Bed-Of-Nails-Test-Fixture-Senior-Design/Hardware/README.md

## HARDWARE - BED OF NAILS TEST FIXTURE
In order to have all the library dependencies resolved, you may have to clone the following library: https://github.com/waltoncade/ComLib

BOM: https://docs.google.com/spreadsheets/d/1WrwzJUxgYZxQ-m_5U3LW8MFK-BtWamYw5t6W2Ptqv70/edit?usp=sharing
