Bed-Of-Nails-Test-Fixture-Senior-Design/Hardware/LTSpice/CutoffvsStopband.png

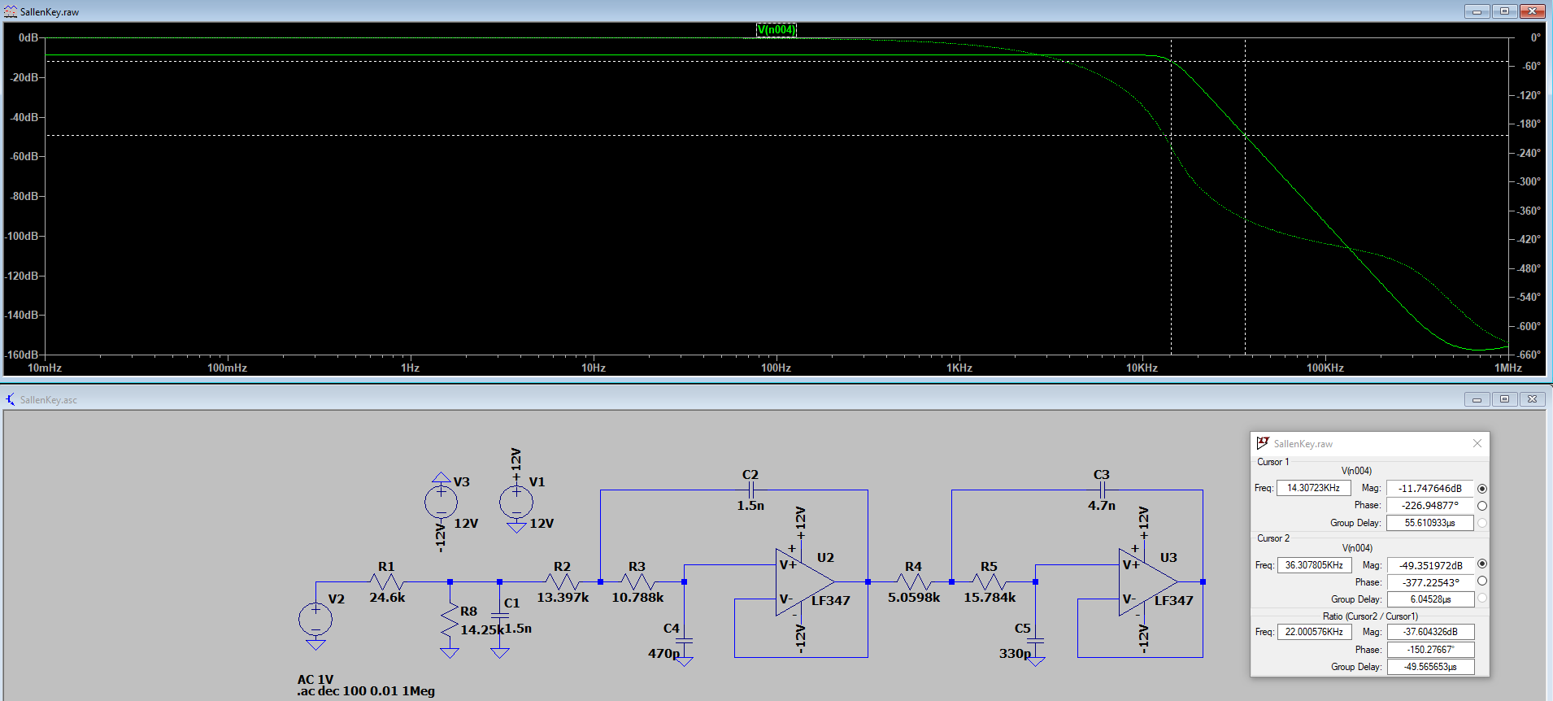
LTSpice/CutoffvsStopband.png
