Bed-Of-Nails-Test-Fixture-Senior-Design/Hardware/LTSpice/Input_Impedance.png

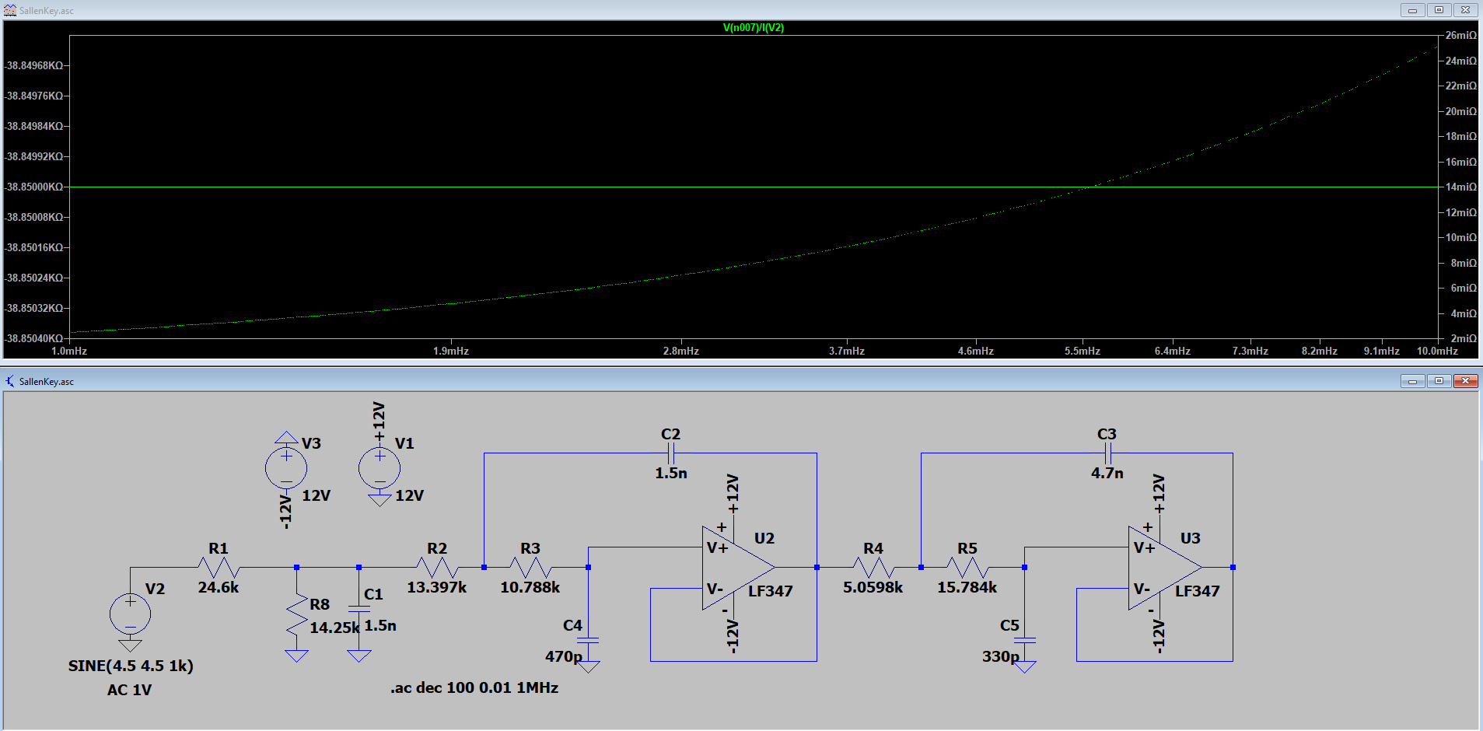
LTSpice/Input_Impedance.png
