Bed-Of-Nails-Test-Fixture-Senior-Design/Hardware/LTSpice/PassbandvsCutoff.png

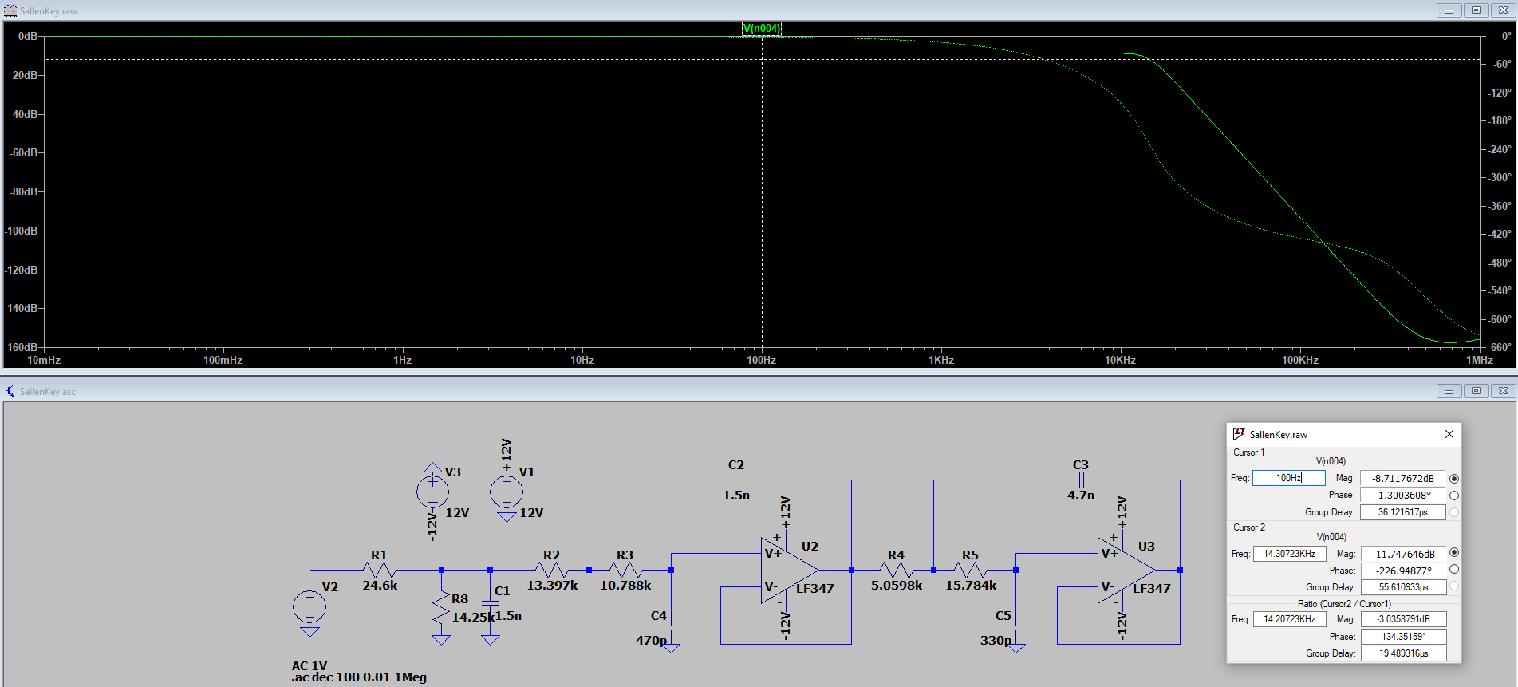
LTSpice/PassbandvsCutoff.png
