Bed-Of-Nails-Test-Fixture-Senior-Design/Hardware/LTSpice/Filters/Real_Test/Expected_Test.png

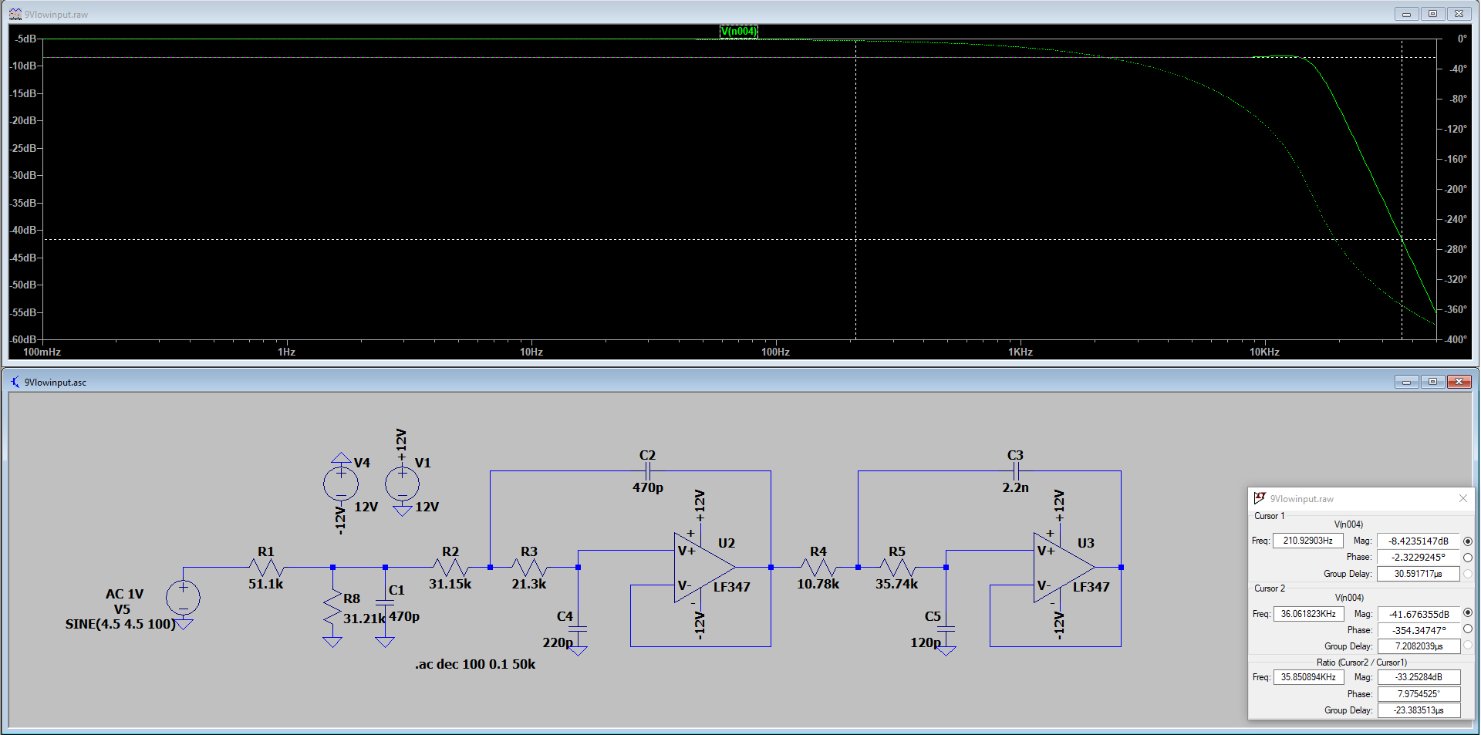
LTSpice/Filters/Real_Test/Expected_Test.png
