Bed-Of-Nails-Test-Fixture-Senior-Design/Hardware/KiCAD/Outputs/Pancake.pdf

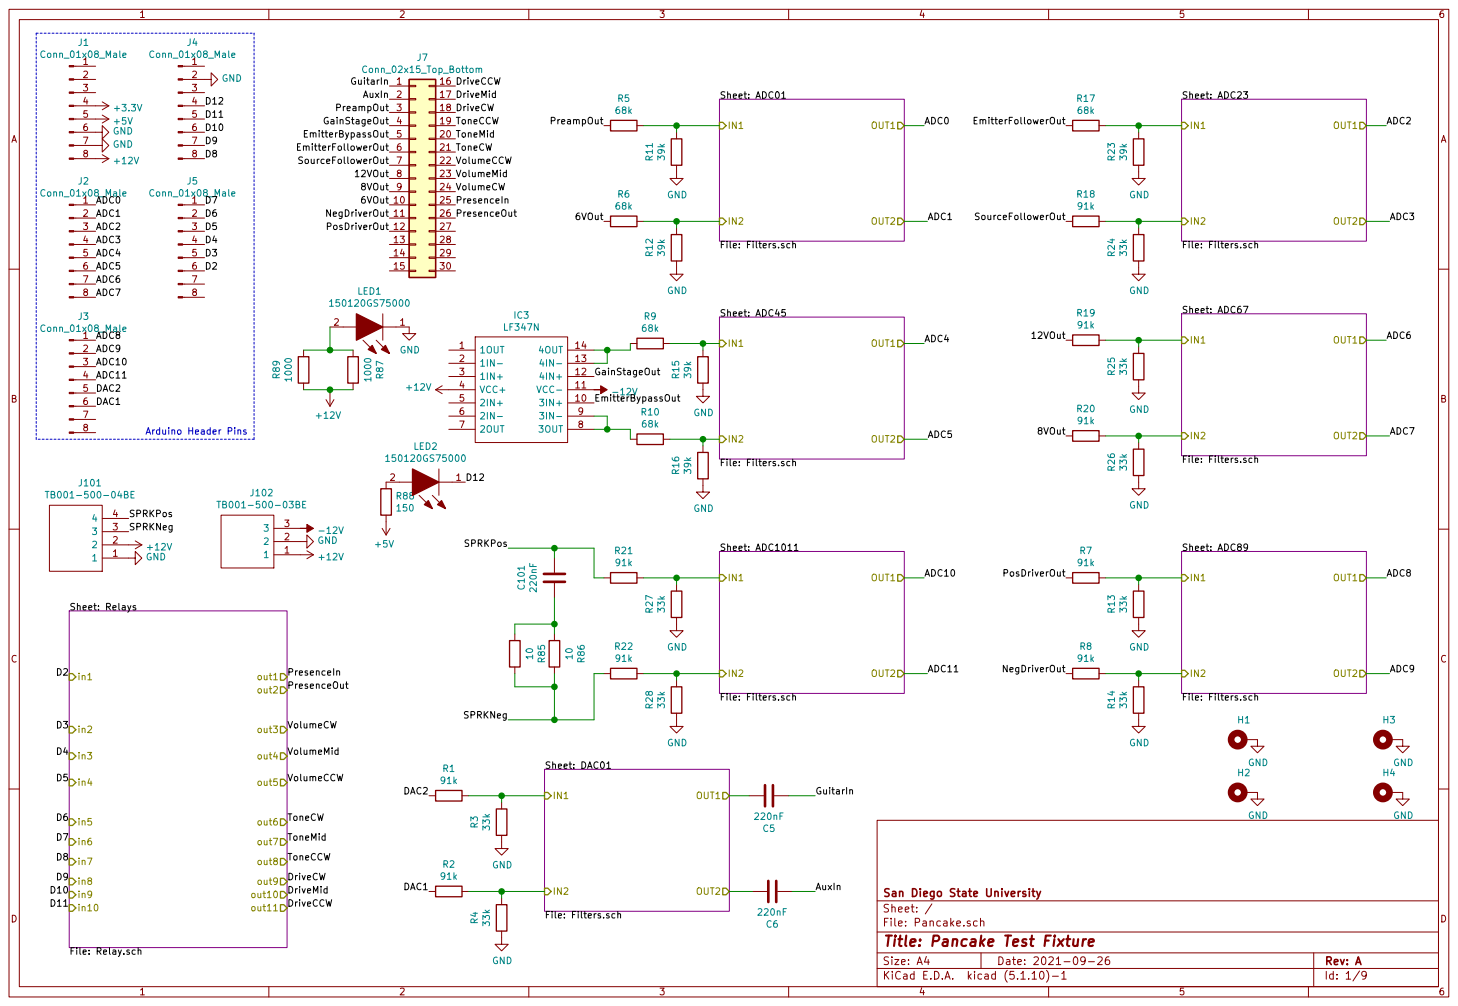
[picture p8: page 1]

PreampOut GuitarIn D9 Arduino Header Pins

Sheet: ADC01 File: Filters.sch

Sheet: ADC23 File: Filters.sch

Sheet: ADC45 File: Filters.sch

File: Pancake.sch Sheet: / San Diego State University

Id: 1/9 Title: Pancake Test Fixture

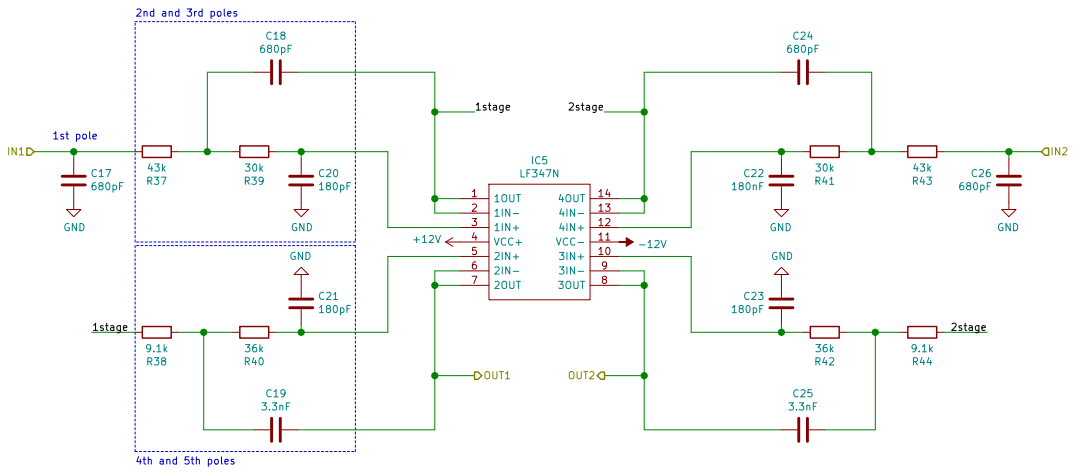
[picture p9: page 2]

File: Filters.sch Sheet: /ADC1011/ San Diego State University

Id: 2/9 Title: Pancake Test Fixture

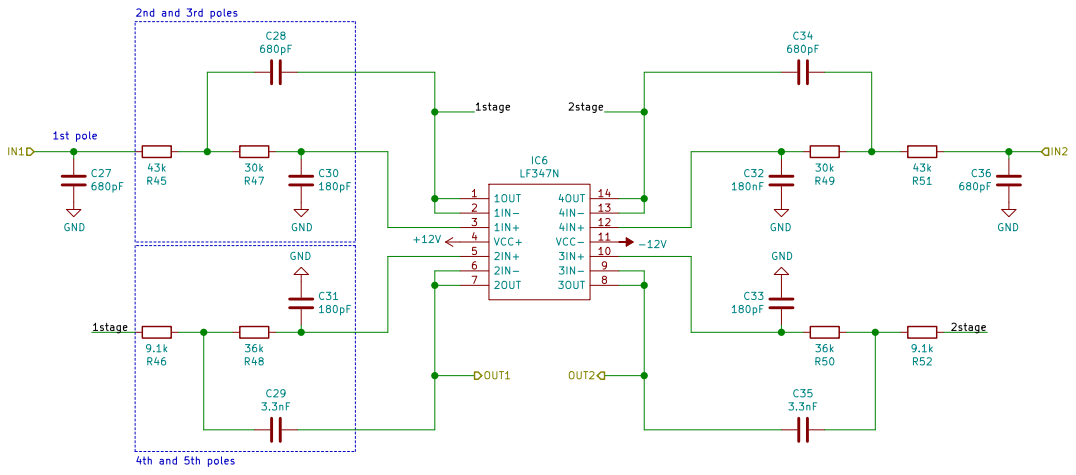
[picture p10: page 3]

File: Filters.sch Sheet: /ADC67/ San Diego State University

Id: 3/9 Title: Pancake Test Fixture

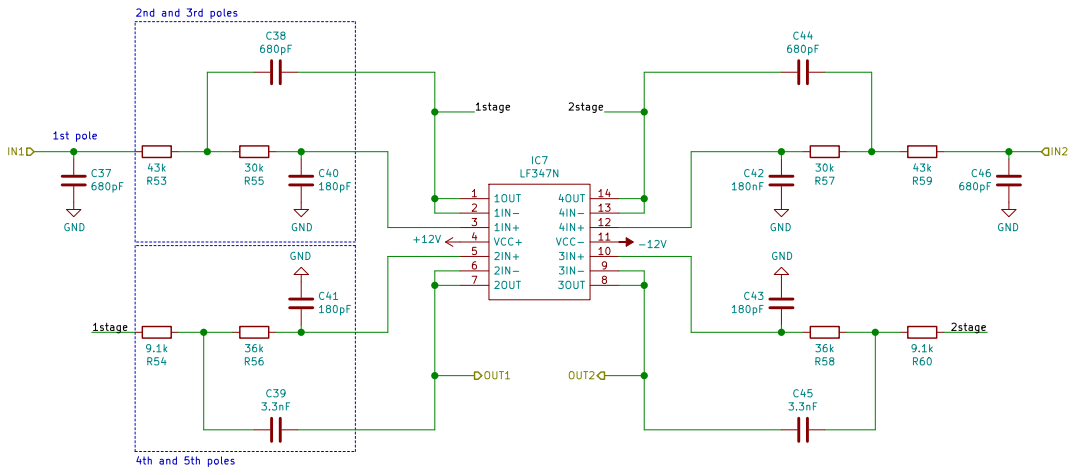
[picture p11: page 4]

File: Filters.sch Sheet: /ADC23/ San Diego State University

Id: 4/9 Title: Pancake Test Fixture

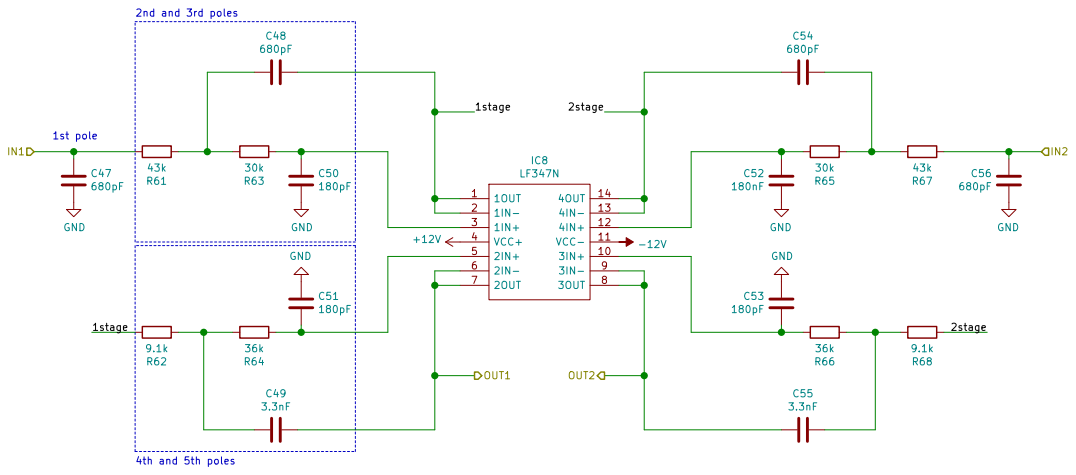
[picture p12: page 5]

File: Filters.sch Sheet: /ADC45/ San Diego State University

Id: 5/9 Title: Pancake Test Fixture

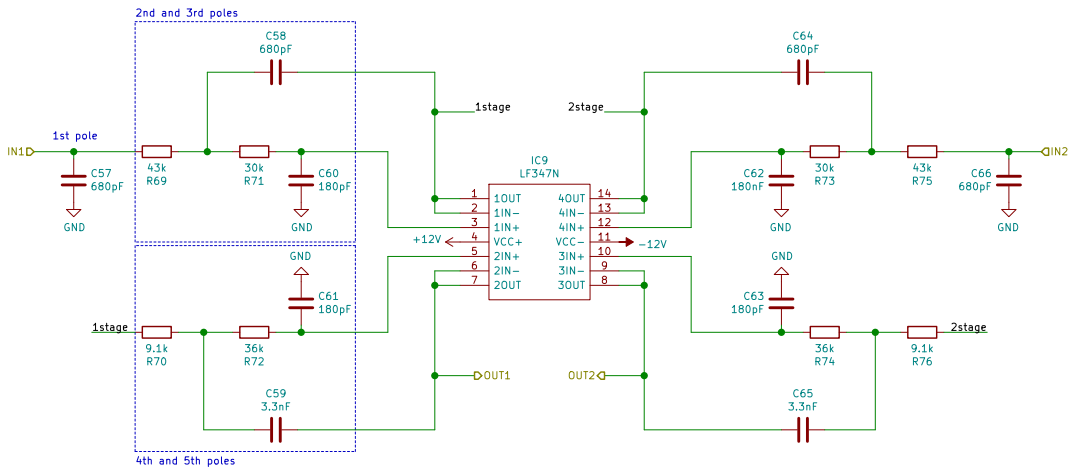
[picture p13: page 6]

File: Filters.sch Sheet: /ADC89/ San Diego State University

Id: 6/9 Title: Pancake Test Fixture

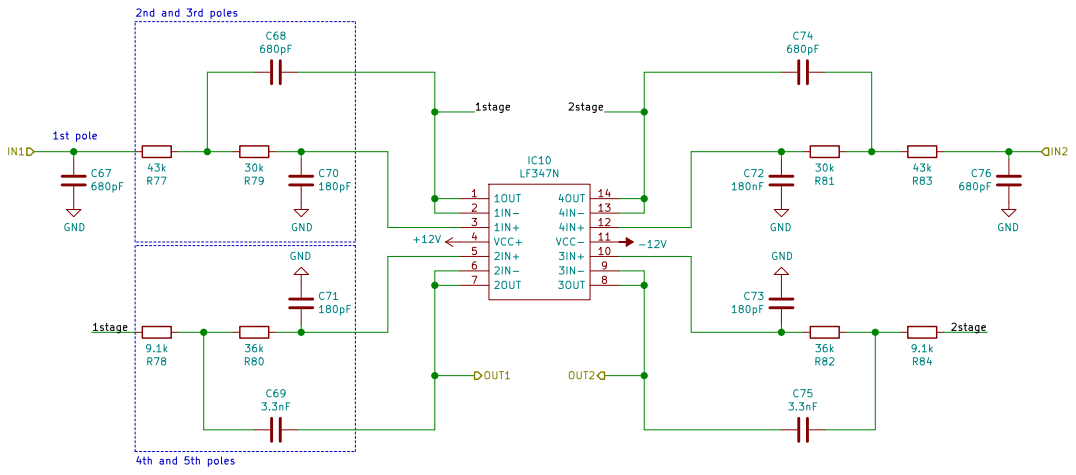
[picture p14: page 7]

File: Filters.sch Sheet: /ADC01/ San Diego State University

Id: 7/9 Title: Pancake Test Fixture

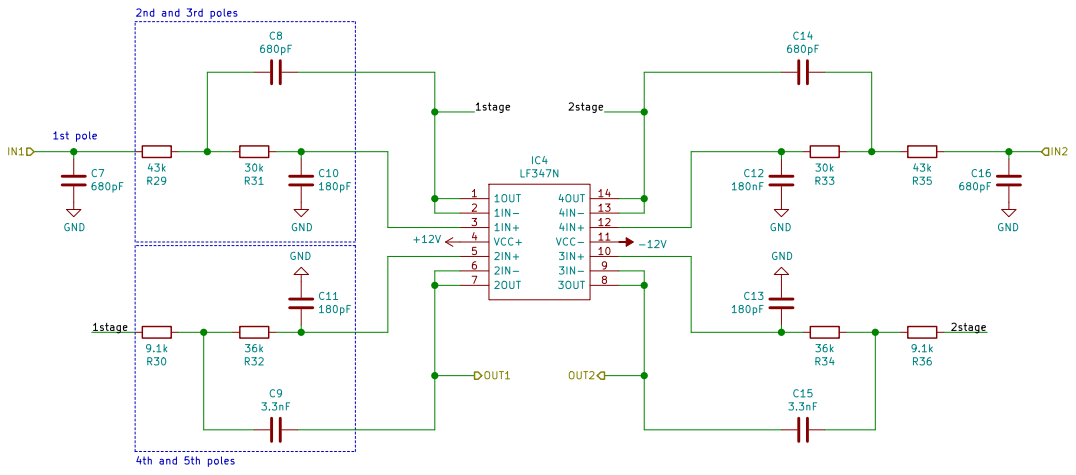
[picture p15: page 8]

File: Filters.sch Sheet: /DAC01/ San Diego State University

Id: 8/9 Title: Pancake Test Fixture

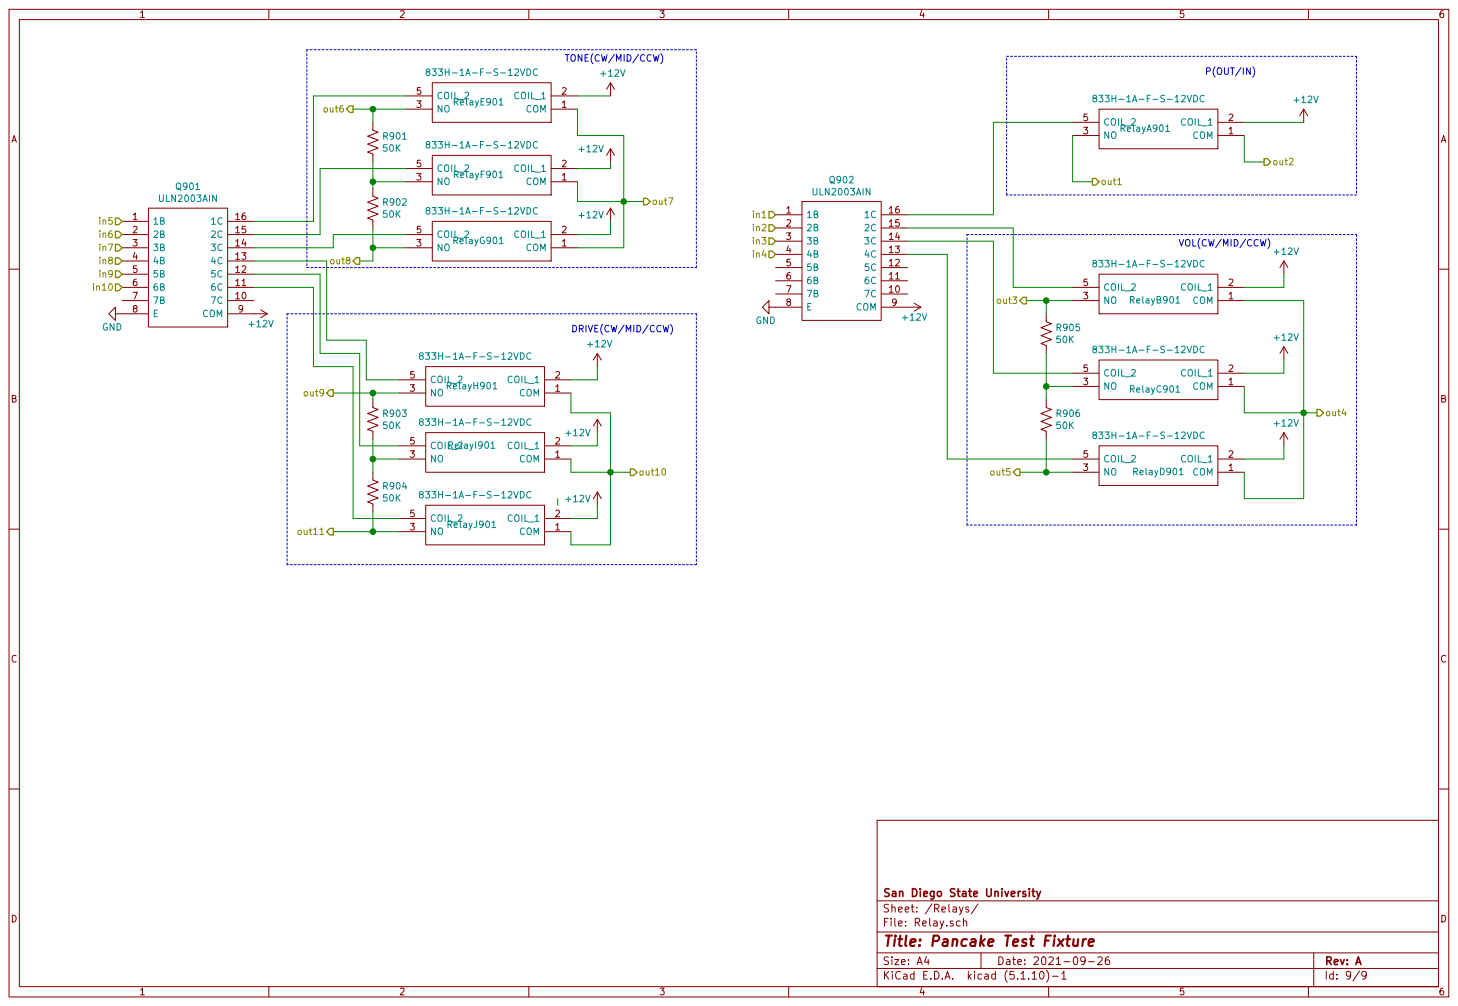
[picture p16: page 9]

TONE(CW/MID/CCW)

VOL(CW/MID/CCW)

San Diego State University
Sheet: /Relays/
File: Relay.sch
Id: 9/9 Title: Pancake Test Fixture
