Bed-Of-Nails-Test-Fixture-Senior-Design/Hardware/LTSpice/Filters/Real_Test/9Vlowinput.asc

C1: cap; 470p
C2: cap; 470p
C3: cap; 2.2n
C4: cap; 220p
C5: cap; 120p
R1: res; 51.1k
R2: res; 31.15k
R3: res; 21.3k
R4: res; 10.78k
R5: res; 35.74k
R8: res; 31.21k
U2: LF347
U3: LF347
V1: voltage; 12V
V4: voltage; 12V
V5: voltage; SINE(4.5 4.5 100); AC 1V
Named nets: +12V, 0, -12V
.ac dec 100 0.1 50k
