Bed-Of-Nails-Test-Fixture-Senior-Design/Hardware/LTSpice/Filters/12V_lowinput/12Vlowinput.asc

C1: cap; 680p
C2: cap; 680p
C3: cap; 3.3n
C4: cap; 180p
C5: cap; 180p
R1: res; 91k
R2: res; 43k
R3: res; 30k
R4: res; 9.1k
R5: res; 36k
R8: res; 33k
U2: LF347
U3: LF347
V1: voltage; 12V
V4: voltage; 12V
V5: voltage; SINE(6 6 100); AC 1V
Named nets: +12V, 0, -12V
.ac dec 100 0.1 50k
