Bed-Of-Nails-Test-Fixture-Senior-Design/Hardware/LTSpice/Filters/power_resistor/power_resistor.asc

C1: cap; 680p
C2: cap; 680p
C3: cap; 3.3n
C4: cap; 180p
C5: cap; 180p
C6: cap; 2200µF
C7: cap; 680p
C8: cap; 680p
C9: cap; 3.3n
C10: cap; 180p
C11: cap; 180p
R1: res; 91k
R2: res; 43k
R3: res; 30k
R4: res; 9.1k
R5: res; 36k
R6: res; 4
R7: res; 91k
R8: res; 33k
R9: res; 43k
R10: res; 30k
R11: res; 9.1k
R12: res; 36k
R13: res; 33k
U1: LF347
U2: LF347
U3: LF347
U4: LF347
V1: voltage; 12V
V2: voltage; ""; AC 1V
V3: voltage; ""; AC 1v
V4: voltage; 12V
V5: voltage; 6V
Named nets: +12V, 0, -12V
.ac dec 100 0.1 1Meg
