Bed-Of-Nails-Test-Fixture-Senior-Design/Hardware/KiCAD/Interface_Board/Daniel's first attempt.kicad_pcb

## KiCad design KiCAD/Interface_Board/Daniel's first attempt.kicad_pcb (2021-11-10)

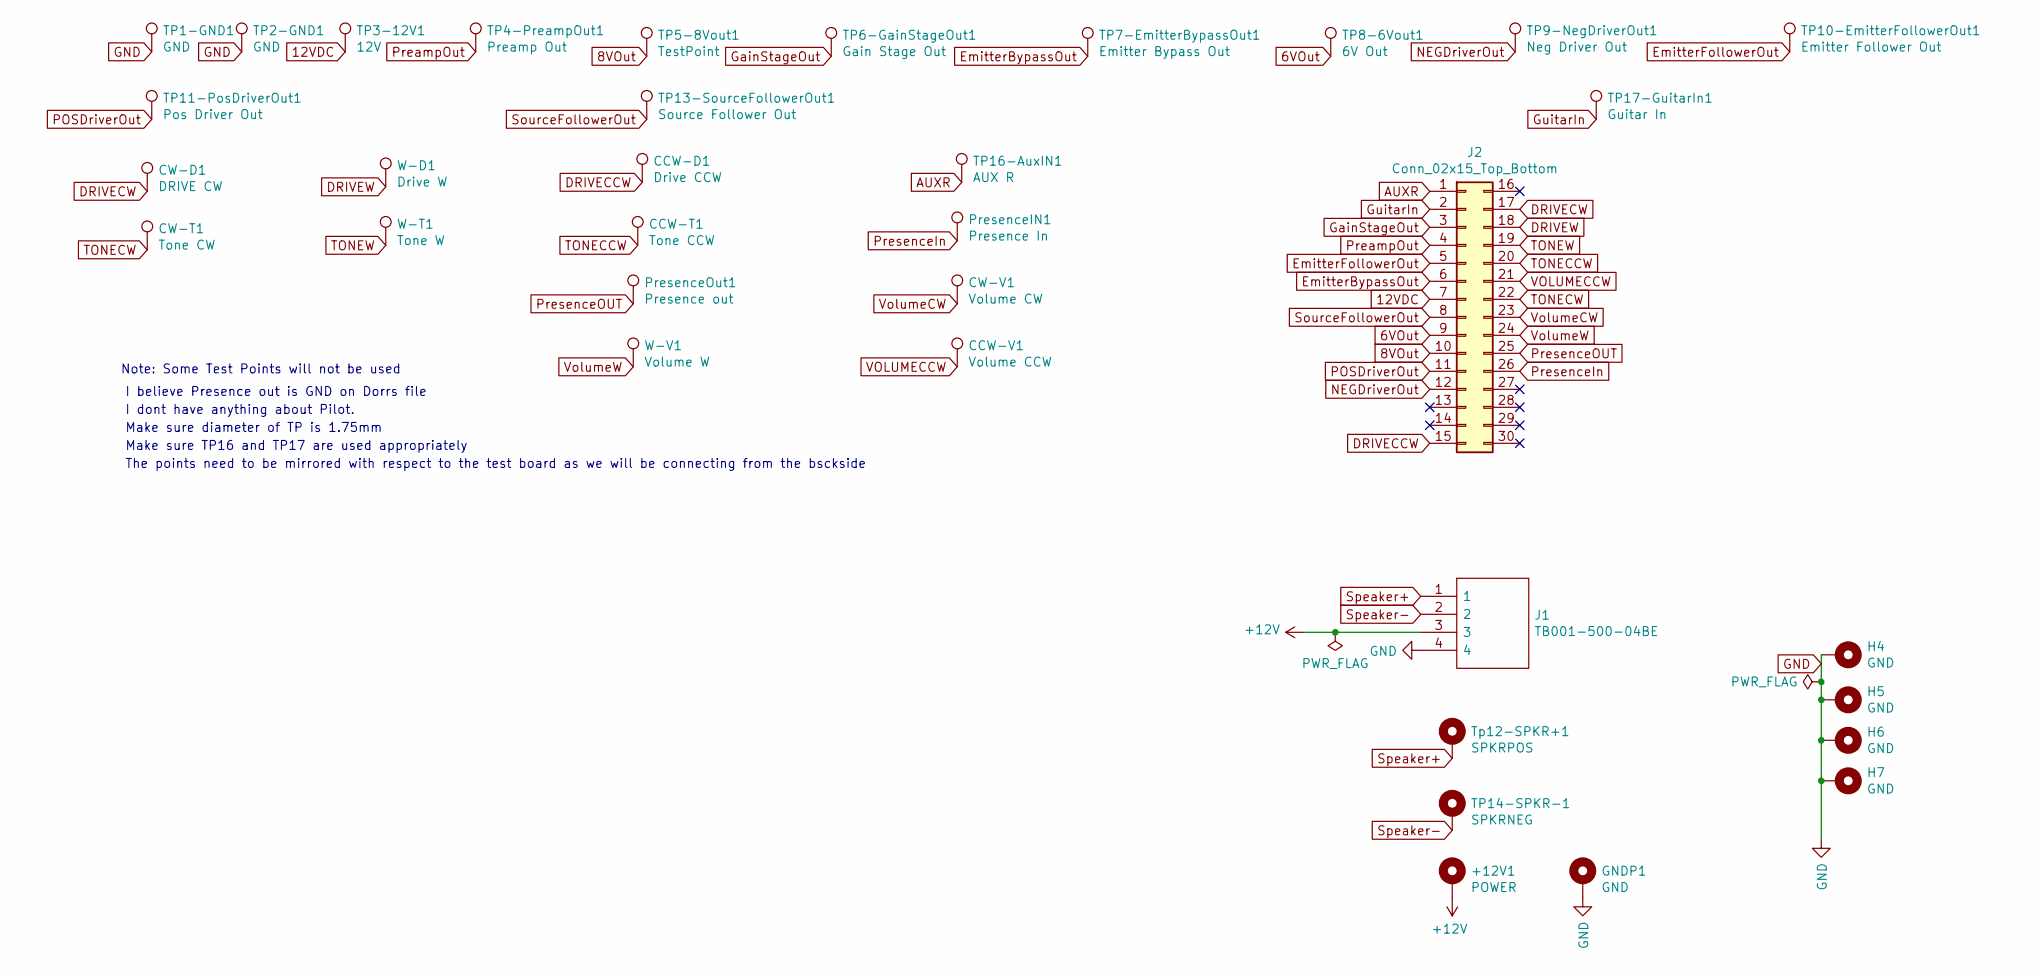
[picture p17: schematic Daniel's first attempt.sch]

Parts:
+12V1: POWER; TestPoint_Plated_Hole_D2.0mm
CCW-D1: Drive CCW; TestPoint_Plated_Hole_D2.0mm
CCW-T1: Tone CCW; TestPoint_Plated_Hole_D2.0mm
CCW-V1: Volume CCW; TestPoint_Plated_Hole_D2.0mm
CW-D1: DRIVE CW; TestPoint_Plated_Hole_D2.0mm
CW-T1: Tone CW; TestPoint_Plated_Hole_D2.0mm
CW-V1: Volume CW; TestPoint_Plated_Hole_D2.0mm
GNDP1: GND; TestPoint_Plated_Hole_D2.0mm
H4, H5, H6, H7: GND; MountingHole_3.7mm_Pad_Via
J1: TB001-500-04BE; TB00150004BE; Manufacturer_Part_Number TB001-500-04BE; Mouser Part Number 490-TB001-500-04BE
J2: Conn_02x15_Top_Bottom; PinSocket_2x15_P2.54mm_Vertical
PresenceIN1: Presence In; TestPoint_Plated_Hole_D2.0mm
PresenceOut1: Presence out; TestPoint_Plated_Hole_D2.0mm
TP1-GND1, TP2-GND1: GND; TestPoint_Plated_Hole_D2.0mm
TP3-12V1: 12V; TestPoint_Plated_Hole_D2.0mm
TP4-PreampOut1: Preamp Out; TestPoint_Plated_Hole_D2.0mm
TP5-8Vout1: TestPoint; TestPoint_Plated_Hole_D2.0mm
TP6-GainStageOut1: Gain Stage Out; TestPoint_Plated_Hole_D2.0mm
TP7-EmitterBypassOut1: Emitter Bypass Out; TestPoint_Plated_Hole_D2.0mm
TP8-6Vout1: 6V Out; TestPoint_Plated_Hole_D2.0mm
TP9-NegDriverOut1: Neg Driver Out; TestPoint_Plated_Hole_D2.0mm
TP10-EmitterFollowerOut1: Emitter Follower Out; TestPoint_Plated_Hole_D2.0mm
TP11-PosDriverOut1: Pos Driver Out; TestPoint_Plated_Hole_D2.0mm
TP13-SourceFollowerOut1: Source Follower Out; TestPoint_Plated_Hole_D2.0mm
TP14-SPKR-1: SPKRNEG; TestPoint_Plated_Hole_D2.0mm
TP16-AuxIN1: AUX R; TestPoint_Plated_Hole_D2.0mm
TP17-GuitarIn1: Guitar In; TestPoint_Plated_Hole_D2.0mm
Tp12-SPKR+1: SPKRPOS; TestPoint_Plated_Hole_D2.0mm
W-D1: Drive W; TestPoint_Plated_Hole_D2.0mm
W-T1: Tone W; TestPoint_Plated_Hole_D2.0mm
W-V1: Volume W; TestPoint_Plated_Hole_D2.0mm

Connections:
6VOut: J2.9, TP8-6Vout1.1
8VOut: J2.10, TP5-8Vout1.1
12VDC: J2.7, TP3-12V1.1
+12V: +12V1.1, J1.3
AUXR: J2.1, TP16-AuxIN1.1
DRIVECCW: CCW-D1.1, J2.15
DRIVECW: CW-D1.1, J2.17
DRIVEW: J2.18, W-D1.1
EmitterBypassOut: J2.6, TP7-EmitterBypassOut1.1
EmitterFollowerOut: J2.5, TP10-EmitterFollowerOut1.1
GND: GNDP1.1, H4.1, H5.1, H6.1, H7.1, J1.4, TP1-GND1.1, TP2-GND1.1
GainStageOut: J2.3, TP6-GainStageOut1.1
GuitarIn: J2.2, TP17-GuitarIn1.1
NEGDriverOut: J2.12, TP9-NegDriverOut1.1
POSDriverOut: J2.11, TP11-PosDriverOut1.1
PreampOut: J2.4, TP4-PreampOut1.1
PresenceIn: J2.26, PresenceIN1.1
PresenceOUT: J2.25, PresenceOut1.1
SourceFollowerOut: J2.8, TP13-SourceFollowerOut1.1
Speaker+: J1.1, Tp12-SPKR+1.1
Speaker-: J1.2, TP14-SPKR-1.1
TONECCW: CCW-T1.1, J2.20
TONECW: CW-T1.1, J2.22
TONEW: J2.19, W-T1.1
VOLUMECCW: CCW-V1.1, J2.21
VolumeCW: CW-V1.1, J2.23
VolumeW: J2.24, W-V1.1

Notes on the sheet:
Note: Some Test Points will not be used
I believe Presence out is GND on Dorrs file
I dont have anything about Pilot.
Make sure diameter of TP is 1.75mm
Make sure TP16 and TP17 are used appropriately
The points need to be mirrored with respect to the test board as we will be connecting from the bsckside

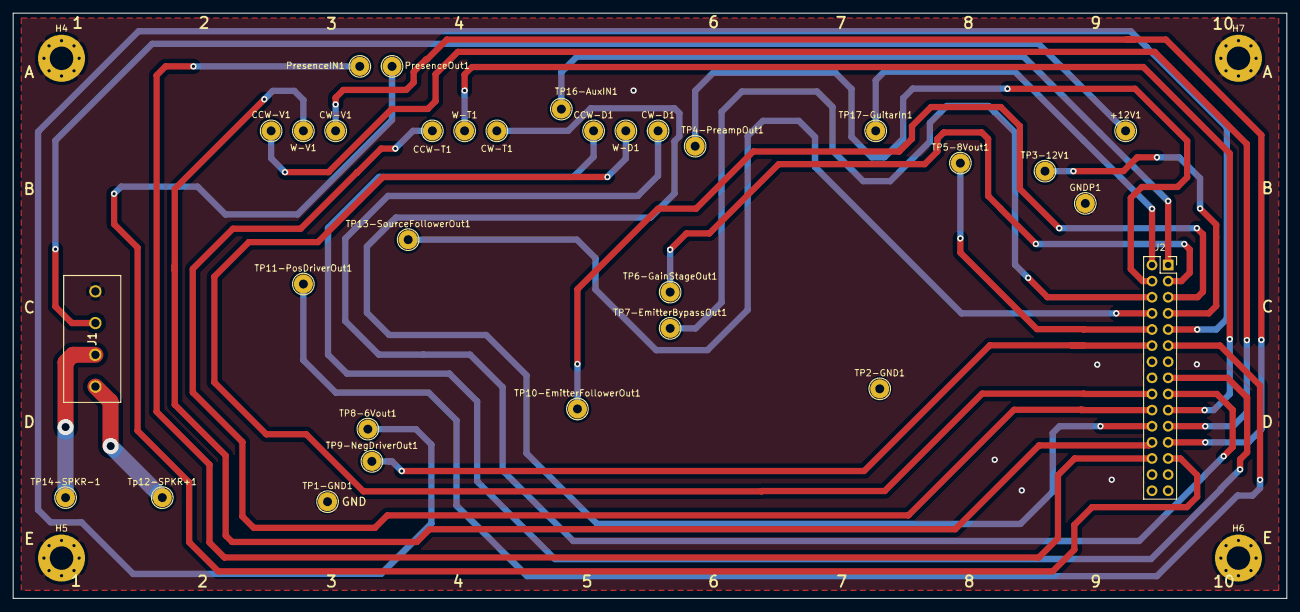
[picture p18: board Daniel's first attempt.kicad_pcb from above]

Board: 2 copper layers, 200.7 x 92.2 mm, 35 parts (0 on the bottom side), 27 nets.
