Bed-Of-Nails-Test-Fixture-Senior-Design/Hardware/(commit log)

2021-02-22 Hysteresis Circuit finished!
2021-02-23 Circuit design finished!
2021-03-12 Finished mini-project
    [KiCAD Schematic and PCB - Quick Design Example and Build-B_Cu.gbr, KiCAD Schematic and PCB - Quick Design Example and Build-B_Mask.gbr, KiCAD Schematic and PCB - Quick Design Example and Build-B_Paste.gbr, KiCAD Schematic and PCB - Quick Design Example and Build-Edge_Cuts.gbr, KiCAD Schematic and PCB - Quick Design Example and Build-F_Cu.gbr, KiCAD Schematic and PCB - Quick Design Example and Bui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]
2021-04-20 Cleaning up directory structure and adding firmware schematic
2021-06-22 Cleaned up fall directory
    [KiCAD Schematic and PCB - Quick Design Example and Build-B_Cu.gbr, KiCAD Schematic and PCB - Quick Design Example and Build-B_Mask.gbr, KiCAD Schematic and PCB - Quick Design Example and Build-B_Paste.gbr, KiCAD Schematic and PCB - Quick Design Example and Build-Edge_Cuts.gbr, KiCAD Schematic and PCB - Quick Design Example and Build-F_Cu.gbr, KiCAD Schematic and PCB - Quick Design Example and Bui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]
2021-07-27 KiCAD PCB started, LTSpice analog filter simulation complete
    [DAC_Filters.sch, Pancake.kicad_pcb, Pancake.sch]
2021-08-27 All input filters/attenuators modeled and tested in ltspice
    [Pancake.sch]
2021-08-27 Extra kicad stuff
    [ADC_Filters.sch, DAC_Filters.sch, Pancake.sch]
2021-09-01 DAC Filters and Relays
    [ADC_Filters.sch, DAC_Filters.sch, Filters.sch, Pancake.sch, Relays.sch]
2021-09-02 Re-did filters for 5% resistors
    [Filters.sch, Pancake.sch]
2021-09-02 Schematic almost complete. layout still required
    [Filters.sch, Pancake.kicad_pcb, Pancake.sch, Relays.sch]
2021-09-02 Ribbon cable connector, arduino layout
    [BOM.xlsx, Pancake.kicad_pcb, Pancake.sch]
2021-09-03 Arduino laid out
    [BOM.xlsx, Filters.sch, Pancake.kicad_pcb, Pancake.sch, Relay.sch, Relays.sch]
2021-09-08 Moved giant component over
    [Pancake.kicad_pcb]
2021-09-08 Power resistor sims
2021-09-09 Have a few more filters to align but I believe the current layout can allow us to route.
    [Pancake.kicad_pcb]
2021-09-10 Going to get big like Justin. Need to clean up ribbon,as there are a few resistors that run a long ways until their only connection.
    [Pancake.kicad_pcb]
2021-09-13 Latest revision
    [Pancake.kicad_pcb, Pancake.sch]
2021-09-13 Lib updates and capacitor add. Simulation on power resistor working
    [BOM.xlsx, Filters.sch, Pancake.kicad_pcb, Pancake.sch, Relay.sch]
2021-09-13 Changed directory structure
    [BOM.xlsx]
2021-09-13 removed docs
    [BOM.xlsx]
2021-09-14 Thiccccc Traces
    [Pancake.kicad_pcb]
2021-09-17 The traces is all that is left. we may fall into problems with mark with clearances, we will see.
    [Filters.sch, Pancake.kicad_pcb, Pancake.sch]
2021-09-19 LED for connection of power. I was not able to find the footprint for the 1206 SMD LED that is in the Senior design lab, but I was able to find one for a similar model. With that being said, the mode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
    [Filters.sch, Pancake.kicad_pcb, Pancake.sch]
2021-09-20 Will need to retrace in order to be built at SDSU.
    [Filters.sch, Pancake.kicad_pcb, Pancake.sch]
2021-09-24 Revising one last time before ordering
    [Filters.sch, Pancake.kicad_pcb, Pancake.sch]
2021-09-24 Moving trace to keep antenna effect low
    [Pancake.kicad_pcb]
2021-09-27 PDF Outputs
    [Filters.sch, Pancake.sch, Relay.sch]
2021-09-28 Give it a look, then let blow the horn.
    [Filters.sch, Pancake.kicad_pcb]
2021-09-29 fills. In checkout when we are ready to send it
    [Pancake.kicad_pcb]
2021-11-04 Bless you Thank you
    [Daniel's first attempt.kicad_pcb, Daniel's first attempt.sch]
2021-11-04 Reminder: Need to change diameter of TP points from 2.0mm to 1.75mm before sign off
    [Daniel's first attempt.kicad_pcb, Daniel's first attempt.sch]
2021-11-05 Zero Vias needed :)!! added vias only for GND if necessary. Note: Since we are plugging in the cable to the bottom of the testboard, the ribbon cable will be flipped therefore, the test points on the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
    [Daniel's first attempt.kicad_pcb, Daniel's first attempt.sch]
2021-11-05 Final Rev 1. Sent To mark to mil, hopefully have before End of Day
    [Daniel's first attempt.kicad_pcb, Daniel's first attempt.sch]
2021-11-10 Missed one
    [Daniel's first attempt.kicad_pcb]
